brks9622/guitarTuner/Documents/MSP430.JPG

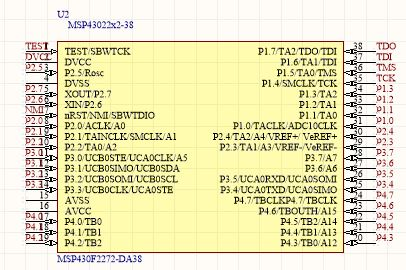
Documents/MSP430.JPG
