brks9622/guitarTuner/Documents/LED_Array.JPG

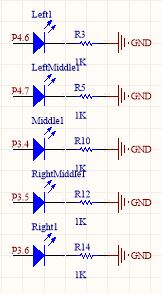
Documents/LED_Array.JPG
