brks9622/guitarTuner/(list of files, drawings)

Other design files:
PCBDesign/DAC.SchDoc
PCBDesign/guitar_tuner.PcbDoc
PCBDesign/guitar_tuner.PrjPCB
PCBDesign/guitar_tuner.SchDoc
PCBDesign/JuniorDesign.PcbLib
PCBDesign/LCD.SchDoc
PCBDesign/LED.SchDoc
PCBDesign/LM386.SchDoc
PCBDesign/LTC1661.PcbLib
PCBDesign/LTC1661.SchLib
PCBDesign/MSP430.SchDoc
PCBDesign/Rpack.PcbLib
PCBDesign/schematic.SchDoc
PCBDesign/SignalAmp.SchDoc
PCBDesign/SIPResistor.SchLib
PCBDesign/switch.SchLib
PCBDesign/temp.PcbDoc
PCBDesign/test.SchDoc
PCBDesign/VoltageSources.SchDoc
