brks9622/guitarTuner/(commit log)

2014-04-09 PCB Upload
    [guitar_tuner.PrjPCB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]
2014-04-09 Fixed close connections, Not complete
    [DAC.SchDoc, JuniorDesign.PcbLib, LCD.SchDoc, LED.SchDoc, LM386.SchDoc, LTC1661.PcbLib, LTC1661.SchLib, MSP430.SchDoc]
2014-04-09 Upload PCB
    [guitar_tuner.PcbDoc]
2014-04-12 update, not complete
    [guitar_tuner.PrjPCB, guitar_tuner.SchDoc]
2014-04-12 update dekstop
    [guitar_tuner.PrjPCB]
2014-04-16 update, still no zero crossing detection
    [guitar_tuner.SchDoc]
2014-04-17 PCB 2.0, Initial design, zero crossing still doesn't work
    [guitar_tuner.PcbDoc, guitar_tuner.SchDoc]
2014-04-18 "Final submit on 2.0"
    [guitar_tuner.PcbDoc, guitar_tuner.PrjPCB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]
2014-04-24 update_pc
    from pc
    [guitar_tuner.SchDoc]
